russss/esp32-ethernet/README.md

An ESP32 board with ethernet support.

Currently a prototype, not guaranteed to work.
