russss/esp32-ethernet/pdf/v1.0.pdf

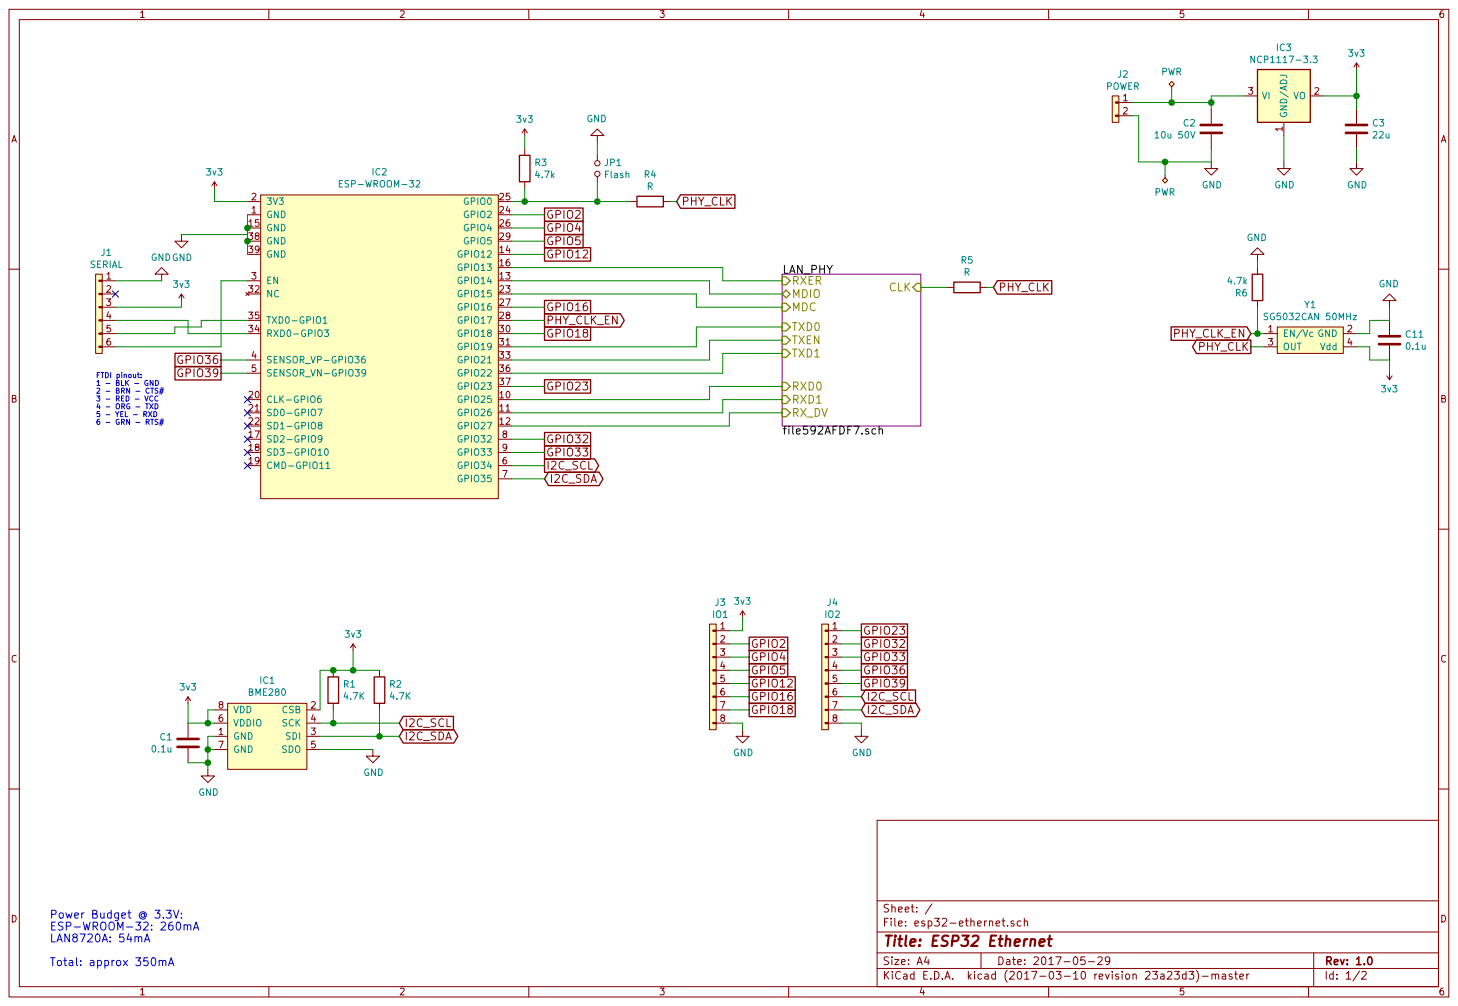
[picture p1: page 1]

FTDI pinout: 1 - BLK - GND
2 - BRN - CTS#
3 - RED - VCC
4 - ORG - TXD
5 - YEL - RXD

File: esp32-ethernet.sch Sheet: /
Id: 1/2 Title: ESP32 Ethernet

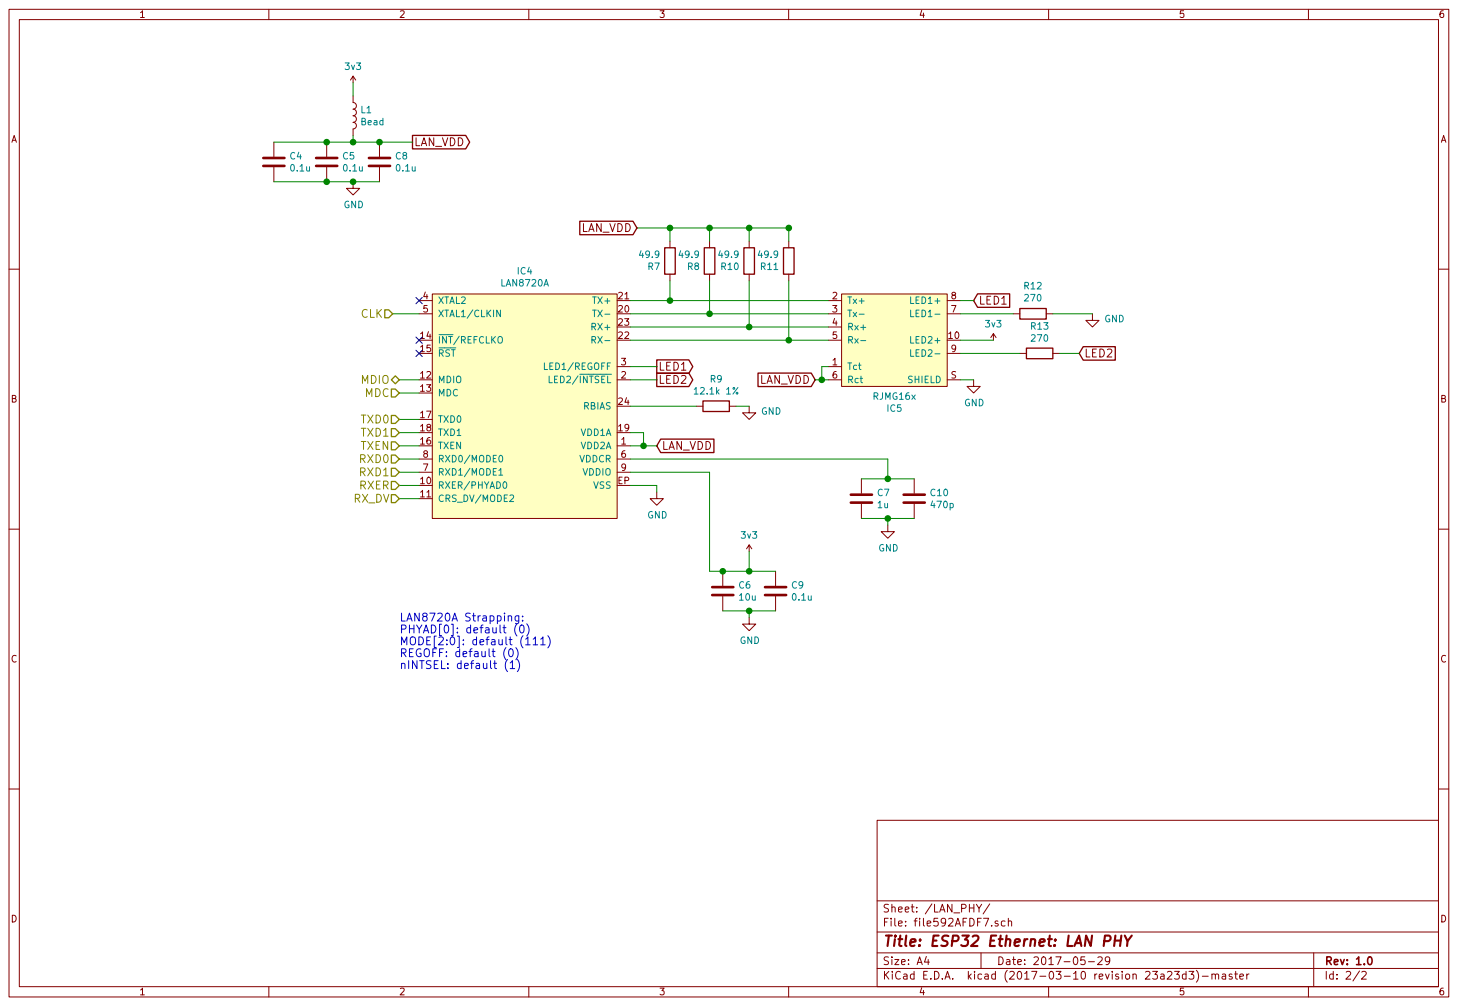
[picture p2: page 2]

File: file592AFDF7.sch Sheet: /LAN_PHY/
Id: 2/2 Title: ESP32 Ethernet: LAN PHY
