russss/esp32-ethernet/esp32-ethernet.kicad_pcb

## KiCad design esp32-ethernet.kicad_pcb (2017-05-29)

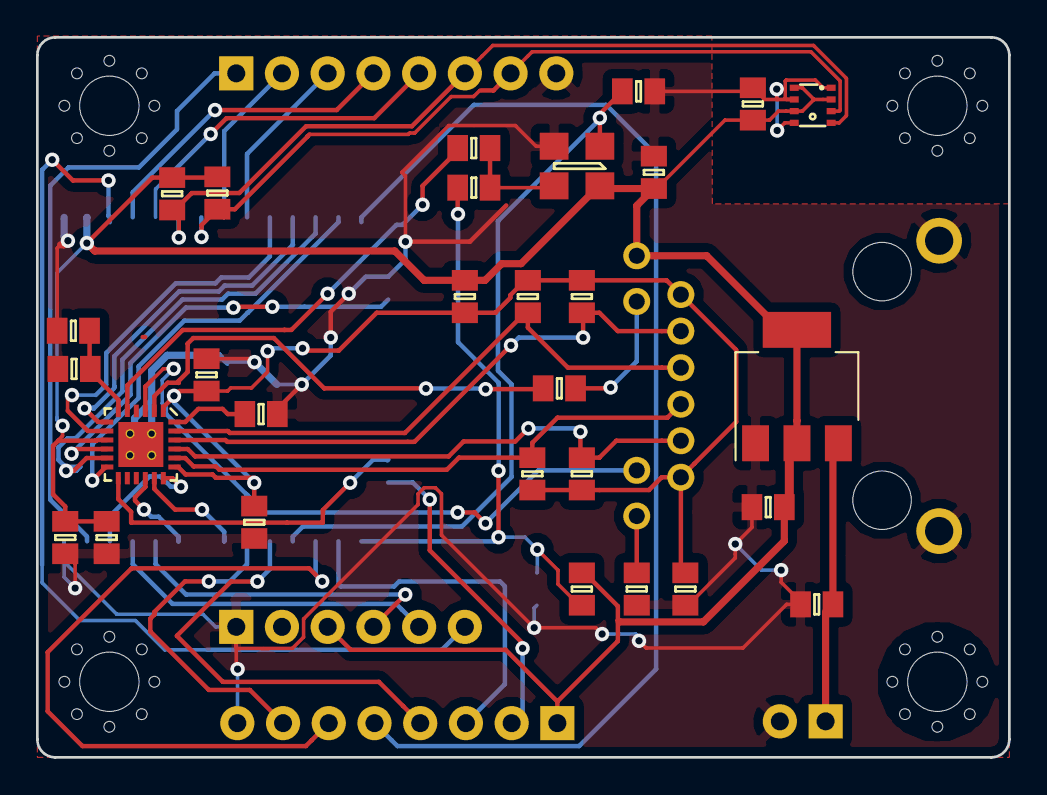
[picture p3: board esp32-ethernet.kicad_pcb from above]

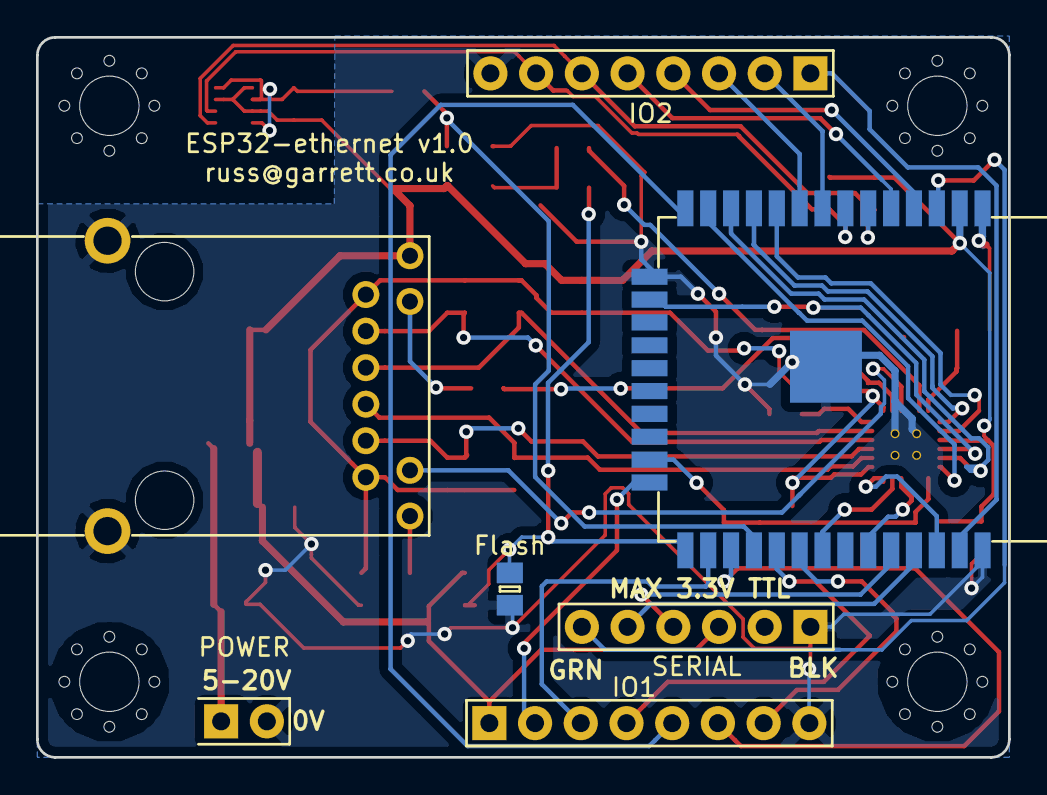
[picture p4: board esp32-ethernet.kicad_pcb from below]

Board: 2 copper layers, 54.0 x 40.0 mm, 36 parts (7 on the bottom side), 43 nets.

Parts:
C1, C4, C5, C8, C9, C11: 0.1u; 0805
C2: 10u 50V; 0805
C3: 22u; 0805
C6: 10u; 0805
C7: 1u; 0805
C10: 470p; 0805
IC1: BME280
IC2: ESP-WROOM-32
IC3: NCP1117-3.3; SOT-223
IC4: LAN8720A; QFN-24-EP-MICROCHIP
IC5: RJMG16x; RJMG16X
J1: SERIAL; SIL-254P-06
J2: POWER; DIL-254P-02
J3: IO1; SIL-254P-08
J4: IO2; SIL-254P-08
JP1: Flash; 0805
L1: Bead; 0805
R1, R2: 4.7K; 0805
R3, R6: 4.7k; 0805
R4, R5: R; 0805
R7, R8, R10, R11: 49.9; 0805
R9: 12.1k 1%; 0805
R12, R13: 270; 0805
Y1: SG5032CAN 50MHz; SG5032CxN

Connections:
3v3: C1.1, C3.1, C6.1, C9.1, C11.2, IC1.2, IC1.6, IC1.8, IC2.2, IC3.2, IC3.4, IC4.9, IC5.10, J1.3, J3.1, L1.1, R1.1, R2.1, R3.1, Y1.4
/LAN_PHY/CLK: IC4.5, R5.2
/LAN_PHY/MDC: IC2.23, IC4.13
/LAN_PHY/MDIO: IC2.13, IC4.12
/LAN_PHY/RXD0: IC2.10, IC4.8
/LAN_PHY/RXD1: IC2.11, IC4.7
/LAN_PHY/RXER: IC2.16, IC4.10
/LAN_PHY/RX_DV: IC2.12, IC4.11
/LAN_PHY/TXD0: IC2.31, IC4.17
/LAN_PHY/TXD1: IC2.36, IC4.18
/LAN_PHY/TXEN: IC2.33, IC4.16
GND: C1.2, C2.2, C3.2, C4.2, C5.2, C6.2, C7.2, C8.2, C9.2, C10.2, C11.1, IC1.1, IC1.5, IC1.7, IC2.1, IC2.15, IC2.38, IC2.39, IC3.1, IC4.EP, IC5.S, J1.1, J2.2, J3.8, J4.8, JP1.1, R6.2, R9.1, R12.2, Y1.2
GPIO2: IC2.24, J3.2
GPIO4: IC2.26, J3.3
GPIO5: IC2.29, J3.4
GPIO12: IC2.14, J3.5
GPIO16: IC2.27, J3.6
GPIO18: IC2.30, J3.7
GPIO23: IC2.37, J4.1
GPIO32: IC2.8, J4.2
GPIO33: IC2.9, J4.3
GPIO36: IC2.4, J4.4
GPIO39: IC2.5, J4.5
I2C_SCL: IC1.4, IC2.6, J4.6, R1.2
I2C_SDA: IC1.3, IC2.7, J4.7, R2.2
LAN_VDD: C4.1, C5.1, C8.1, IC4.1, IC4.19, IC5.1, IC5.6, L1.2, R7.2, R8.2, R10.2, R11.2
LED1: IC4.3, IC5.8
LED2: IC4.2, R13.1
unnamed: C2.1, IC3.3, J2.1
unnamed: C7.1, C10.1, IC4.6
unnamed: IC2.3, J1.6
unnamed: IC2.25, JP1.2, R3.2, R4.2
unnamed: IC2.34, J1.4
unnamed: IC2.35, J1.5
unnamed: IC4.20, IC5.3, R8.1
unnamed: IC4.21, IC5.2, R7.1
unnamed: IC4.22, IC5.5, R11.1
unnamed: IC4.23, IC5.4, R10.1
unnamed: IC4.24, R9.2
unnamed: IC5.7, R12.1
unnamed: IC5.9, R13.2
PHY_CLK: R4.1, R5.1, Y1.3
PHY_CLK_EN: IC2.28, R6.1, Y1.1
